openbraces/CPSC-6820/README.md

# CPSC-6820 Classwork

## Resources

- For composing LaTeX documents, VScode with [LaTeX Workshop](https://marketplace.visualstudio.com/items?itemName=James-Yu.latex-workshop) can be used. I personally have a full TeX Live distribution installed on my machine.
