openbraces/CPSC-6820/Deliverable #2/document.tex

\documentclass{article}

\usepackage{graphicx}
\usepackage{booktabs}
\usepackage{array}
\usepackage{lscape}
\usepackage{tikz}
\usetikzlibrary{shapes.geometric, shapes.misc, positioning, arrows}
\usepackage{float}
\usepackage{tabularx}
\usepackage[colorlinks=true,urlcolor=blue,bookmarksopen=true]{hyperref}
\usepackage{ltxtable}

\title{Automatic Pet Feeder\\
\large CPSC-6820 Deliverable \#2---System Overview Document}
\author{Logan Swoyer \and Sriram Vishnubhotla}
\date{February 2025}

\begin{document}

\maketitle

\section{Executive Summary}
It feels terrible to realize we did not feed our pets---whether it is because we were running late and were in a hurry or had too much on our mind and forgot about it. Times like these are when the Automatic Pet Feeder comes in handy. It comes with a nifty set of features to take care of your pet feeding needs including---the ability to set multiple food dispense times a day, on-device dispense schedule settings, internet connectivity to pair your mobile devices and publish logs, a mobile app to receive notifications and view logs as well as to set the dispense schedule and the ability to set dispense quantities per each dispense time. Internet connectivity is completely optional and is helpful to check logs and remotely edit the dispense schedule.

\section{System Description}
\subsection{Software}
The device's main loop can be logically divided into three phases: reading from and writing to I/O---including rendering on-device display based on button inputs and activating the buzzer, pushing device state to the web server and updating the local state from the web server's state, setting the timers based on the schedules and dispensing food when the timers are triggered. The following sections lay out more details of these phases.
\subsubsection{Device I/O}
For the device to be self-sufficient without internet connectivity, the on-device display needs to act as a comprehensive user interface. <figure> shows the planned frame layout. The frame consists of a number input at the center to take schedule times and portion sizes as inputs, icons on the left---including internet connectivity indicator, storage level indicator and schedule identifier. The schedule identifier can be toggled to view or edit multiple schedules, each of which is identified by the identifier. The display would be controlled using a joystick--select button combo input and a buzzer would be fired to alert the pet/user when dispensing food.
\subsubsection{Web Interoperation}
The device would be equipped with a Wi-Fi module that sets up a private wireless network to pair with a mobile device, which needs a client app installed. The user's home network credentials will then be exchanged with the device for it to establish a connection with the network. Once this step succeeds, the device would be ready to go online and synchronize device state with data on the server. This includes the device clock and the dispense schedule and portion sizes. From this point, the device would push activity data to the server---which would be used by the mobile app, for instance, to notify the user when food is dispensed or if the storage level is low.
\subsubsection{Scheduling and Dispensing}
% TODO: Research on MSP430 timer limits and check if a dedicated timer is required.
Schedules are set using the microcontroller's online timers and TI's RTC library. The timer interrupts trigger the device to serve food in the container.
\subsubsection{UI}
The device's user interface would consist of a power on--off switch, a joystick, a buzzer and an LCD display. The joy stick will be used by the user to control selection on the LCD display. The LCD display will visualize setting the device clock, the dispense schedule and portion sizes and alert the user of warnings. The buzzer is used in order to alert the user or pet when food is being dispensed.

Besides this, a companion mobile app will be developed to achieve the same functionality remotely, while accessing device logs.
\begin{figure}[H]
    
    \caption{Device display prototype.}
\end{figure}
\subsection{State Machine}
\begin{figure}[H]
    \centering
    \input{statemachine.tex}
    \caption{Automatic Pet Feeder's state machine.}
\end{figure}
\subsection{Hardware}
\subsubsection{Sensors}
The device will have two sensors, a force sensor and an optical sensor. The force sensor is used to measure the amount of food in the dispense container before and during dispensing. This will allow the device to dispense the proper amount of food set by the user. The optical sensor is used in order to measure the amount of food left in the storage. This allows the user to be alerted when food is running low so they can refill it.
\subsubsection{Microcontroller}
We plan to use MSP430FR5994 in order to control this device. Using this microcontroller eases the workload since we can reuse the knowledge of the MCU we learned in class.
\subsubsection{Actuator}
The device will be equipped with a linear actuator that will be in charge of opening and closing the dispenser. We made sure to choose one that can handle enough force to reliably hold the weight of the food.
\subsubsection{Wireless communication protocol}
For our wireless component we decided to use a Wi-Fi module. This module will be used to connect to the user's home network and communicate with the web server.
\subsection{Parts}
\begin{table}[H]
    \begin{tabularx}{\linewidth}{@{} X X >{\raggedleft\hsize=0.25\hsize}X X @{}}
        \toprule
        Title                                                                                                                          & Part \#                   & Price & Supplier              \\ \midrule
        \href{https://www.sparkfun.com/rocker-switch-spst-round.html}{Rocker Switch}                                                   & COM-11138                 & 0.55  & Sparkfun              \\ \midrule
        \href{https://www.adafruit.com/product/512}{Joystick with Select Button}                                                       & 512                       & 5.95  & Adafruit              \\ \midrule
        \href{https://www.digikey.com/en/products/detail/tdk-corporation/PS1240P02BT/935924}{Buzzer}                                   & PS1240P02BT               & 0.55  & TDK Corporation       \\ \midrule
        \href{https://www.digikey.com/en/products/detail/newhaven-display-intl/NHD-C12832A1Z-NSW-BBW-3V3/2059235}{Graphic LCD Display} & NHD-C12832A1Z-NSW-BBW-3V3 & 12.82 & Newhaven Display Intl \\ \midrule
        \href{https://www.digikey.com/en/products/detail/espressif-systems/ESP32-S2FH4/14553010}{WiFi Module}                          & ESP32-S2FH4               & 1.48  & Espressif Systems     \\ \midrule
        \href{https://www.digikey.com/en/products/detail/dfrobot/FIT0803/14824998}{Linear actuator}                                    & FIT0803                   & 24.00 & DFRobot               \\ \midrule
        \href{https://www.digikey.com/en/products/detail/texas-instruments/MSP-EXP430FR5994/6645208}{MSP430FR5994 Microcontroller}     & MSP-EXP430FR5994          & 20.39 & Texas Instruments     \\ \midrule
        \href{https://www.digikey.com/en/products/detail/uneo-inc/GHF-10/15657152}{Force sensor}                                       & GHF-10                    & 5.86  & UNEO Inc.             \\ \midrule
        \href{https://www.digikey.com/en/products/detail/stmicroelectronics/VL6180V1NR-1/7313209}{Optical sensor}                      & VL6180V1NR/1              & 3.37  & STMicroelectronics    \\ \midrule
                                                                                                                                       &                           & 74.97 &                       \\ \bottomrule
    \end{tabularx}
    \caption{Device part list and details.}
\end{table}
\section{Demo}
The demo would begin with us showing the audience the design and features of the device. We would then fill the storage with food, set the dispense container up to collect the food and power the device on. Once done, we would demonstrate the setup phase---which will involve pairing the device with user's mobile and connecting it to a wireless network, followed by setting the feeding schedule and portion sizes. For demonstration purposes, we would set short time intervals to show the functionality. Finally, once everything is set up, we show the device alerting and dispensing the food on time, as well as pushing notifications to the user's mobile device.
\section{Resources, References and Appendix}
\begin{itemize}
    \item \href{https://www.ti.com/lit/an/slaa290a/slaa290a.pdf}{TI---Using the Real-Time Clock Library}
    \item \href{https://software-dl.ti.com/trainingTTO/trainingTTO_public_sw/MSP430_LaunchPad_Workshop/v4/Chapters/MSP430m06_TIMERS.pdf}{TI---Timers}
    \item \href{https://www.ti.com/video/series/msp430-workshop.html}{TI---MSP430 workshop}
    \item \href{https://e2e.ti.com/support/microcontrollers/msp-low-power-microcontrollers-group/msp430/f/msp-low-power-microcontroller-forum/670685/ccs-msp430fr5994-how-to-set-up-t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}{TI forums---Setting up alarms using RTC library}
   \item \href{https://www.espressif.com/sites/default/files/documentation/esp32-s2_datasheet_en.pdf}{WiFi Module Datasheet}
\end{itemize}
\end{document}
