openbraces/CPSC-6820/Deliverable #2/presentation.pdf

## Automatic Pet Feeder

CPSC-6820 Deliverable #2
System Overview Presentation

Sriram Vishnubhotla Logan Swoyer

Clemson University

February 2025

## What and why?

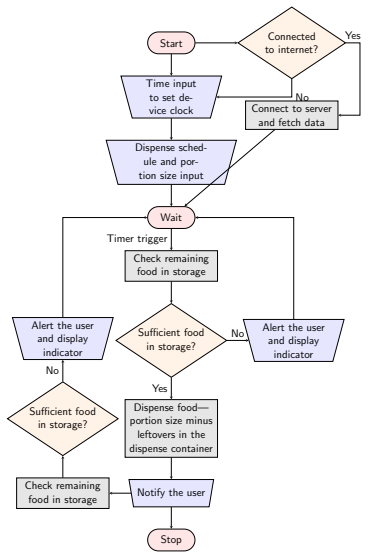
[picture p5: figure]
Start; Time input to set de- vice clock; Dispense sched- ule and por- tion size input; Connected to internet?; Connect to server and fetch data; Wait; Check remaining food in storage; Sufficient food in storage?; Alert the user and display indicator; Dispense food— portion size minus leftovers in the dispense container; Notify the user Check remaining food in storage; Stop; Yes; Timer trigger

What?
- Automatic Pet Feeder
- Set-and-forget food
dispenser for pets

Features:
- Multiple schedules and
portion sizes per schedule
- Wireless connectivity, user alerts and stats
- Replaceable dispense
containers
Why?
- Don’t miss feeding your pets again!
- Privacy and wallet friendly

## Software and UI

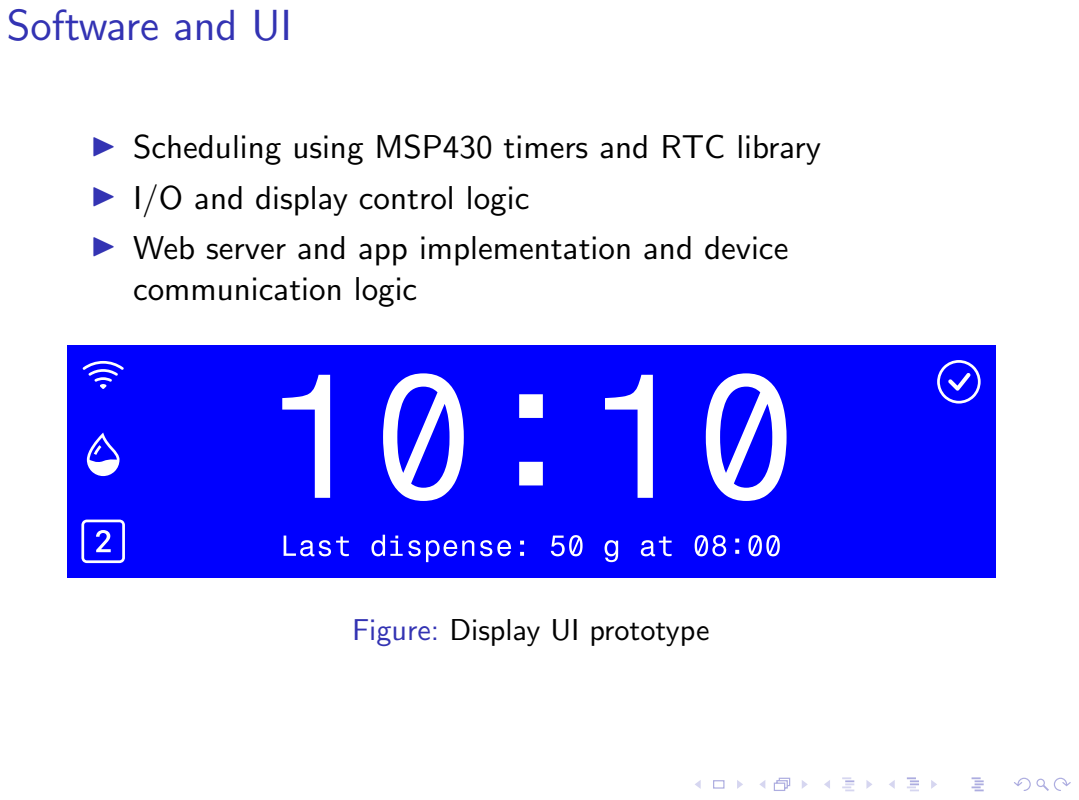
[picture p6: page 3]

▶ Scheduling using MSP430 timers and RTC library
▶ I/O and display control logic
▶ Web server and app implementation and device
communication logic

Last dispense: 50 g at 08:00

Figure: Display UI prototype

## Hardware

Part | Price
Rocker Switch | 0.55
Joystick with Select Button | 5.95
Buzzer | 0.55
Graphic LCD Display | 12.82
WiFi Module | 1.48
Linear actuator | 24.00
MSP430FR5994 Microcontroller | 20.39
Force sensor | 5.86
Optical sensor | 3.37
| 74.97

## Stretch Goals

- Storage partitioning and different types of food
- Battery-powered operation
- Keeping track of pet’s eating habits
- Pet-lock function

## Conclusion

Questions?
