openbraces/CPSC-6820/Deliverable #2/images/displayframe.pdf

10:10

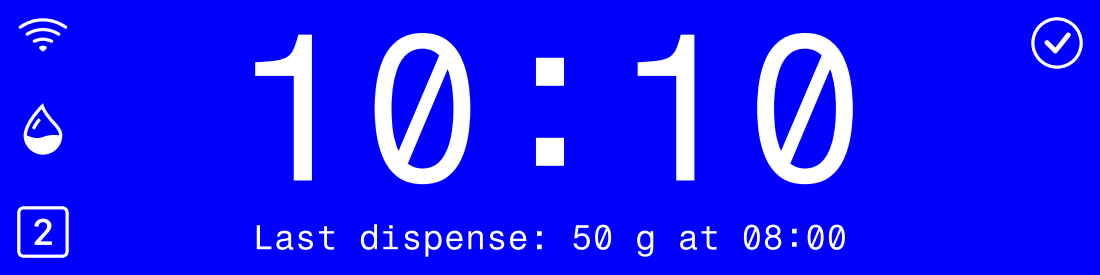
[picture p7: page 1]

Last dispense: 50 g at 08:00
