openbraces/CPSC-6820/Deliverable #6a/dinmeter.jpg

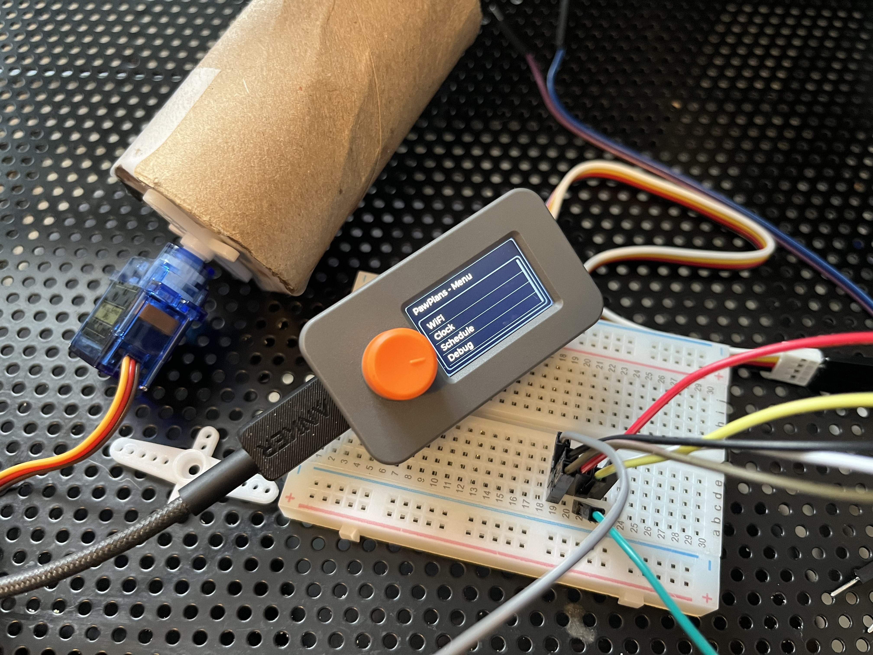
Deliverable #6a/dinmeter.jpg
