openbraces/CPSC-6820/Deliverable #3/Parts/Load Cell Amp (SEN-13879)/SEN-13879.step

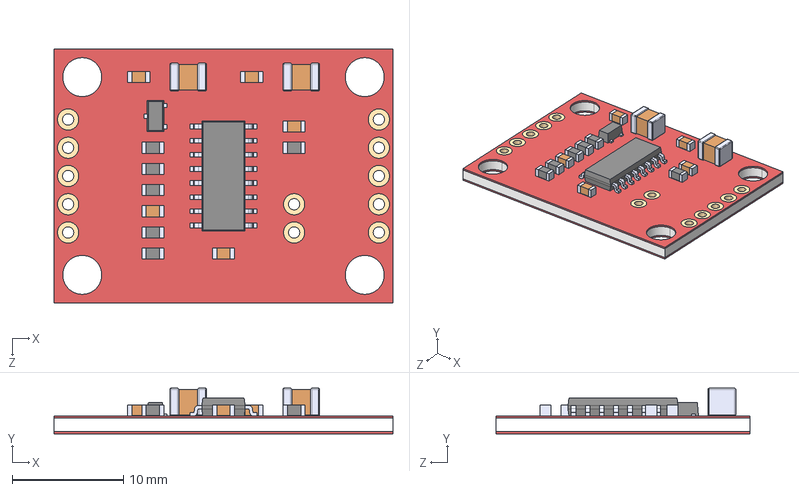
[picture p9: CAD file, 2025-02-20]
Deliverable #3/Parts/Load Cell Amp (SEN-13879)/SEN-13879.step
30.5 x 4.10 x 22.9 mm
