openbraces/CPSC-6820/PawPlans/Hardware/petfeeder2.stl

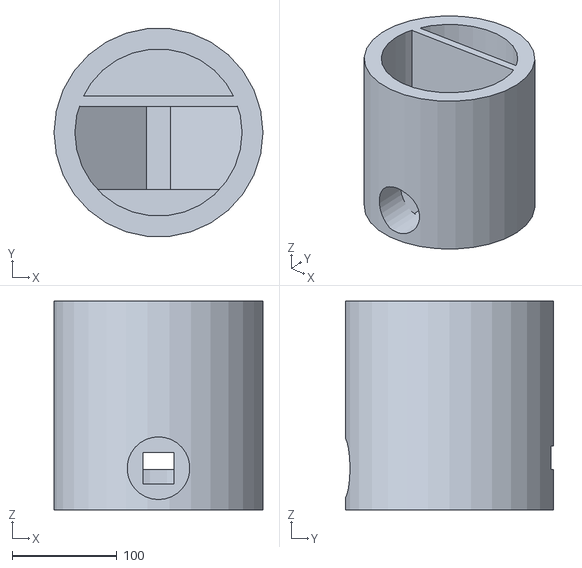
[picture p10: CAD file, 2025-04-15]
PawPlans/Hardware/petfeeder2.stl
200.0 x 198.9 x 200.0
