openbraces/CPSC-6820/PawPlans/Hardware/PawPlans.kicad_pcb

## KiCad design PawPlans/Hardware/PawPlans.kicad_pcb (2025-04-25)

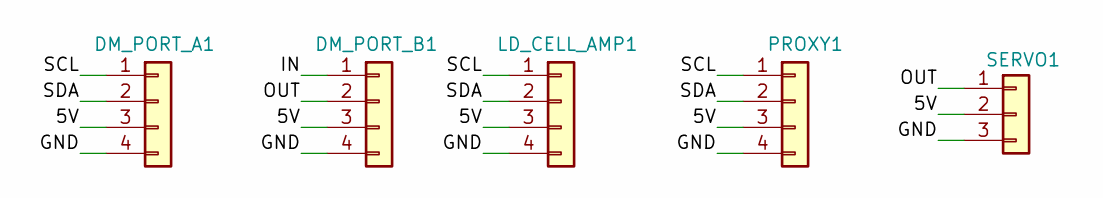
[picture p11: schematic PawPlans.kicad_sch, PawPlans - Automatic Pet Feeder]

Parts:
DM_PORT_A1: Conn_01x04; PinHeader_1x04_P2.54mm_Vertical
DM_PORT_B1: Conn_01x04; PinHeader_1x04_P2.54mm_Vertical
LD_CELL_AMP1: Conn_01x04; PinHeader_1x04_P2.54mm_Vertical
PROXY1: Conn_01x04; PinHeader_1x04_P2.54mm_Vertical
SERVO1: Conn_01x03; PinHeader_1x03_P2.54mm_Vertical

Connections:
/5V: DM_PORT_A1.3 (5V), DM_PORT_B1.3 (5V), LD_CELL_AMP1.3 (5V), PROXY1.3 (5V), SERVO1.2 (5V)
/GND: DM_PORT_A1.4 (GND), DM_PORT_B1.4 (GND), LD_CELL_AMP1.4 (GND), PROXY1.4 (GND), SERVO1.3 (GND)
/IN: DM_PORT_B1.1 (IN)
/OUT: DM_PORT_B1.2 (OUT), SERVO1.1 (SGN)
/SCL: DM_PORT_A1.1 (SCL), LD_CELL_AMP1.1 (SCL), PROXY1.1 (SDA)
/SDA: DM_PORT_A1.2 (SDA), LD_CELL_AMP1.2 (SDA), PROXY1.2 (SDA)

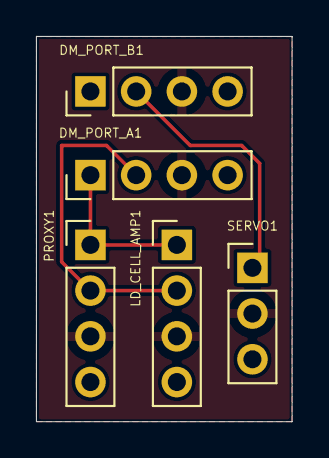
[picture p12: board PawPlans.kicad_pcb from above]

Board: 2 copper layers, 14.2 x 21.4 mm, 5 parts (0 on the bottom side), 5 nets.
