openbraces/CPSC-6820/Deliverable #3/Automatic Pet Feeder.sch

## EAGLE design Deliverable #3/Automatic Pet Feeder.sch (2025-02-20)

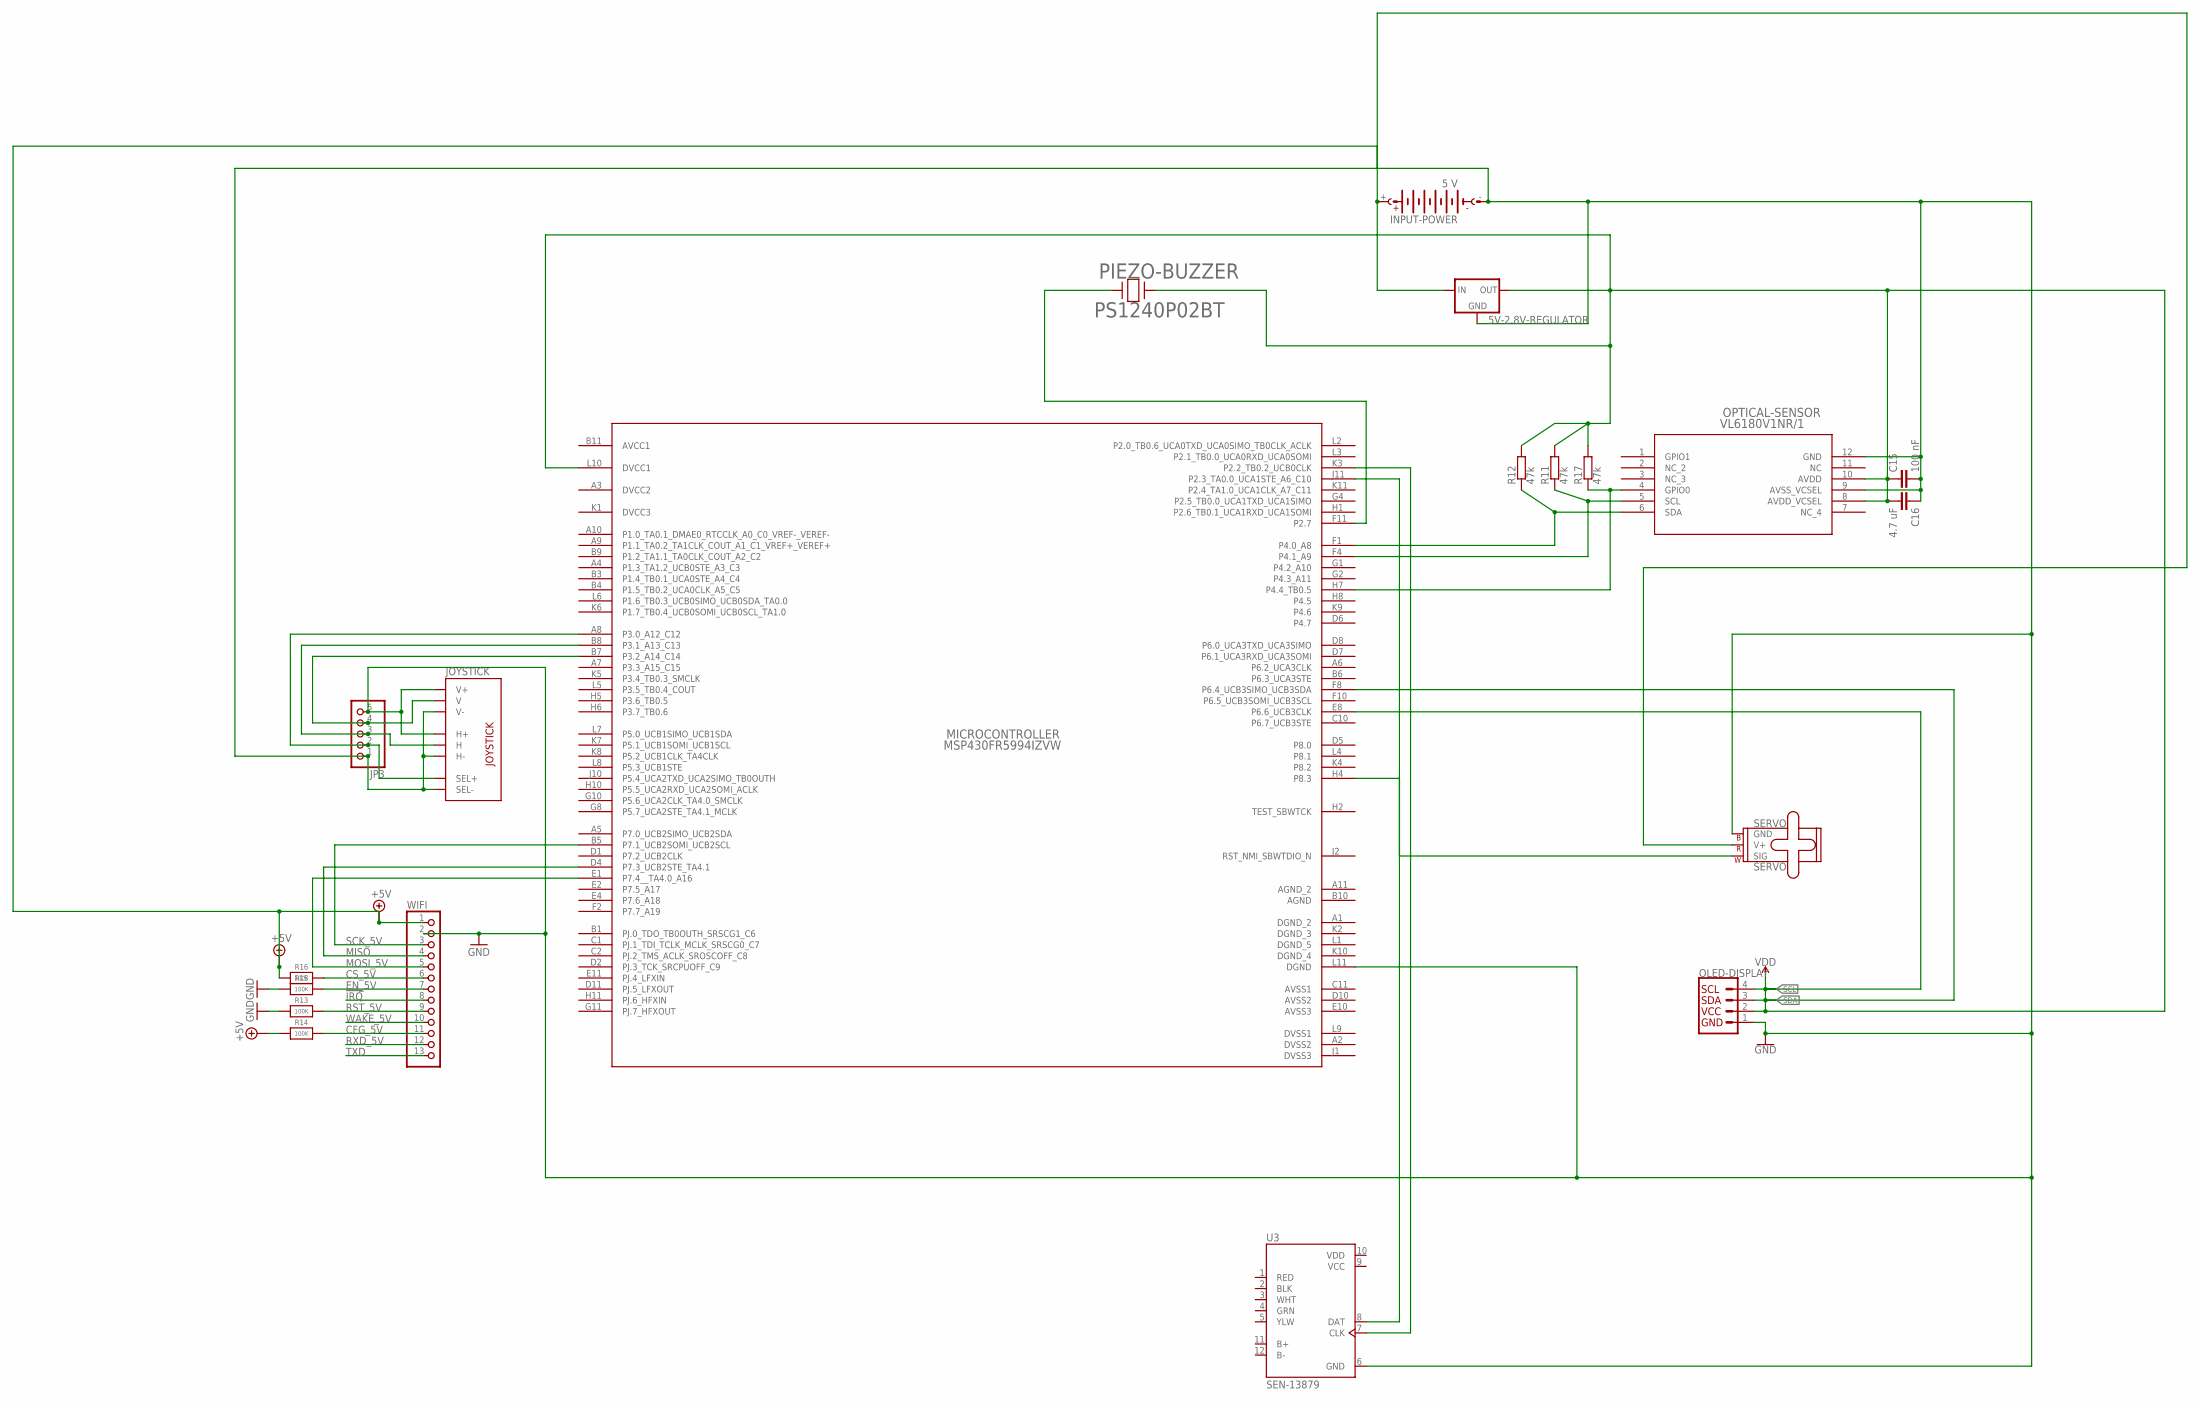
[picture p16: schematic Automatic Pet Feeder.sch, sheet 1]

Parts:
5V-2.8V-REGULATOR: 78XXS
C15: 100 nF; C2.5-2
C16: 4.7 uF; C2.5-2
INPUT-POWER: 5 V; AB9V
JOYSTICK: JOYSTICKPTH; JOYSTICK
JP3: PINHD-1X5; 1X05
MICROCONTROLLER: MSP430FR5994IZVW; ZVW0087A
OLED-DISPLAY: I2C_STANDARD_NO_SILK; 1X04_NO_SILK
OPTICAL-SENSOR: VL6180V1NR/1; VL6180X_STM
PIEZO-BUZZER: PS1240P02BT; XTAL_PS1240P02BT_TDK
R11, R12, R17: 47k; PMD
R13, R14: 100K; 0805-NO
R15, R16: 100K; _0805MP
SERVO: SERVO; 1X03
U3: SEN-13879; SPARKFUN_SEN-13879
WIFI: HEADER-1X13; 1X13_ROUND_70

Connections:
!IRQ: WIFI.8
+5V: 5V-2.8V-REGULATOR.IN, INPUT-POWER.+, R14.1, R16.1, WIFI.1
CFG_5V: R14.2, WIFI.11
CS_5V: R16.2, WIFI.6
EN_5V: R15.2, WIFI.7
GND: 5V-2.8V-REGULATOR.GND, C15.2, C16.1, INPUT-POWER.-, JOYSTICK.B2A (SEL-), JOYSTICK.H1 (H+), JOYSTICK.H3 (H-), JOYSTICK.V1 (V+), JOYSTICK.V3 (V-), JP3.1, JP3.5, MICROCONTROLLER.L11 (DGND), OLED-DISPLAY.1 (GND), OPTICAL-SENSOR.9 (AVSS_VCSEL), OPTICAL-SENSOR.12 (GND), R13.1, R15.1, SERVO.3 (GND), U3.6 (GND), WIFI.2
MISO: MICROCONTROLLER.D4 (P7.3_UCB2STE_TA4.1), WIFI.4
MOSI_5V: MICROCONTROLLER.E1 (P7.4__TA4.0_A16), WIFI.5
unnamed: MICROCONTROLLER.H4 (P8.3), SERVO.1 (SIG)
unnamed: MICROCONTROLLER.K3 (P2.2_TB0.2_UCB0CLK), U3.7 (CLK)
unnamed: JOYSTICK.V2 (V), JP3.4, MICROCONTROLLER.B7 (P3.2_A14_C14)
unnamed: JOYSTICK.H2 (H), JP3.3, MICROCONTROLLER.B8 (P3.1_A13_C13)
unnamed: JOYSTICK.B1A (SEL+), JP3.2, MICROCONTROLLER.A8 (P3.0_A12_C12)
unnamed: MICROCONTROLLER.F11 (P2.7), PIEZO-BUZZER.1
unnamed: MICROCONTROLLER.J11 (P2.3_TA0.0_UCA1STE_A6_C10), U3.8 (DAT)
unnamed: MICROCONTROLLER.H7 (P4.4_TB0.5), OPTICAL-SENSOR.4 (GPIO0), R17.2
unnamed: MICROCONTROLLER.F4 (P4.1_A9), OPTICAL-SENSOR.5 (SCL), R11.2
unnamed: MICROCONTROLLER.F1 (P4.0_A8), OPTICAL-SENSOR.6 (SDA), R12.2
RST_5V: R13.2, WIFI.9
RXD_5V: WIFI.12
SCK_5V: MICROCONTROLLER.B5 (P7.1_UCB2SOMI_UCB2SCL), WIFI.3
SCL: OLED-DISPLAY.4 (SCL)
SDA: OLED-DISPLAY.3 (SDA)
TXD: WIFI.13
VDD: 5V-2.8V-REGULATOR.OUT, C15.1, C16.2, MICROCONTROLLER.E8 (P6.6_UCB3CLK), MICROCONTROLLER.F8 (P6.4_UCB3SIMO_UCB3SDA), MICROCONTROLLER.L10 (DVCC1), OLED-DISPLAY.2 (VCC), OPTICAL-SENSOR.8 (AVDD_VCSEL), OPTICAL-SENSOR.10 (AVDD), PIEZO-BUZZER.2, R11.1, R12.1, R17.1
WAKE_5V: WIFI.10
