openbraces/CPSC-6820/Deliverable #3/Automatic_Pet_Feeder_1.kicad_sch

## KiCad design Deliverable #3/Automatic_Pet_Feeder_1.kicad_sch (2025-02-27)

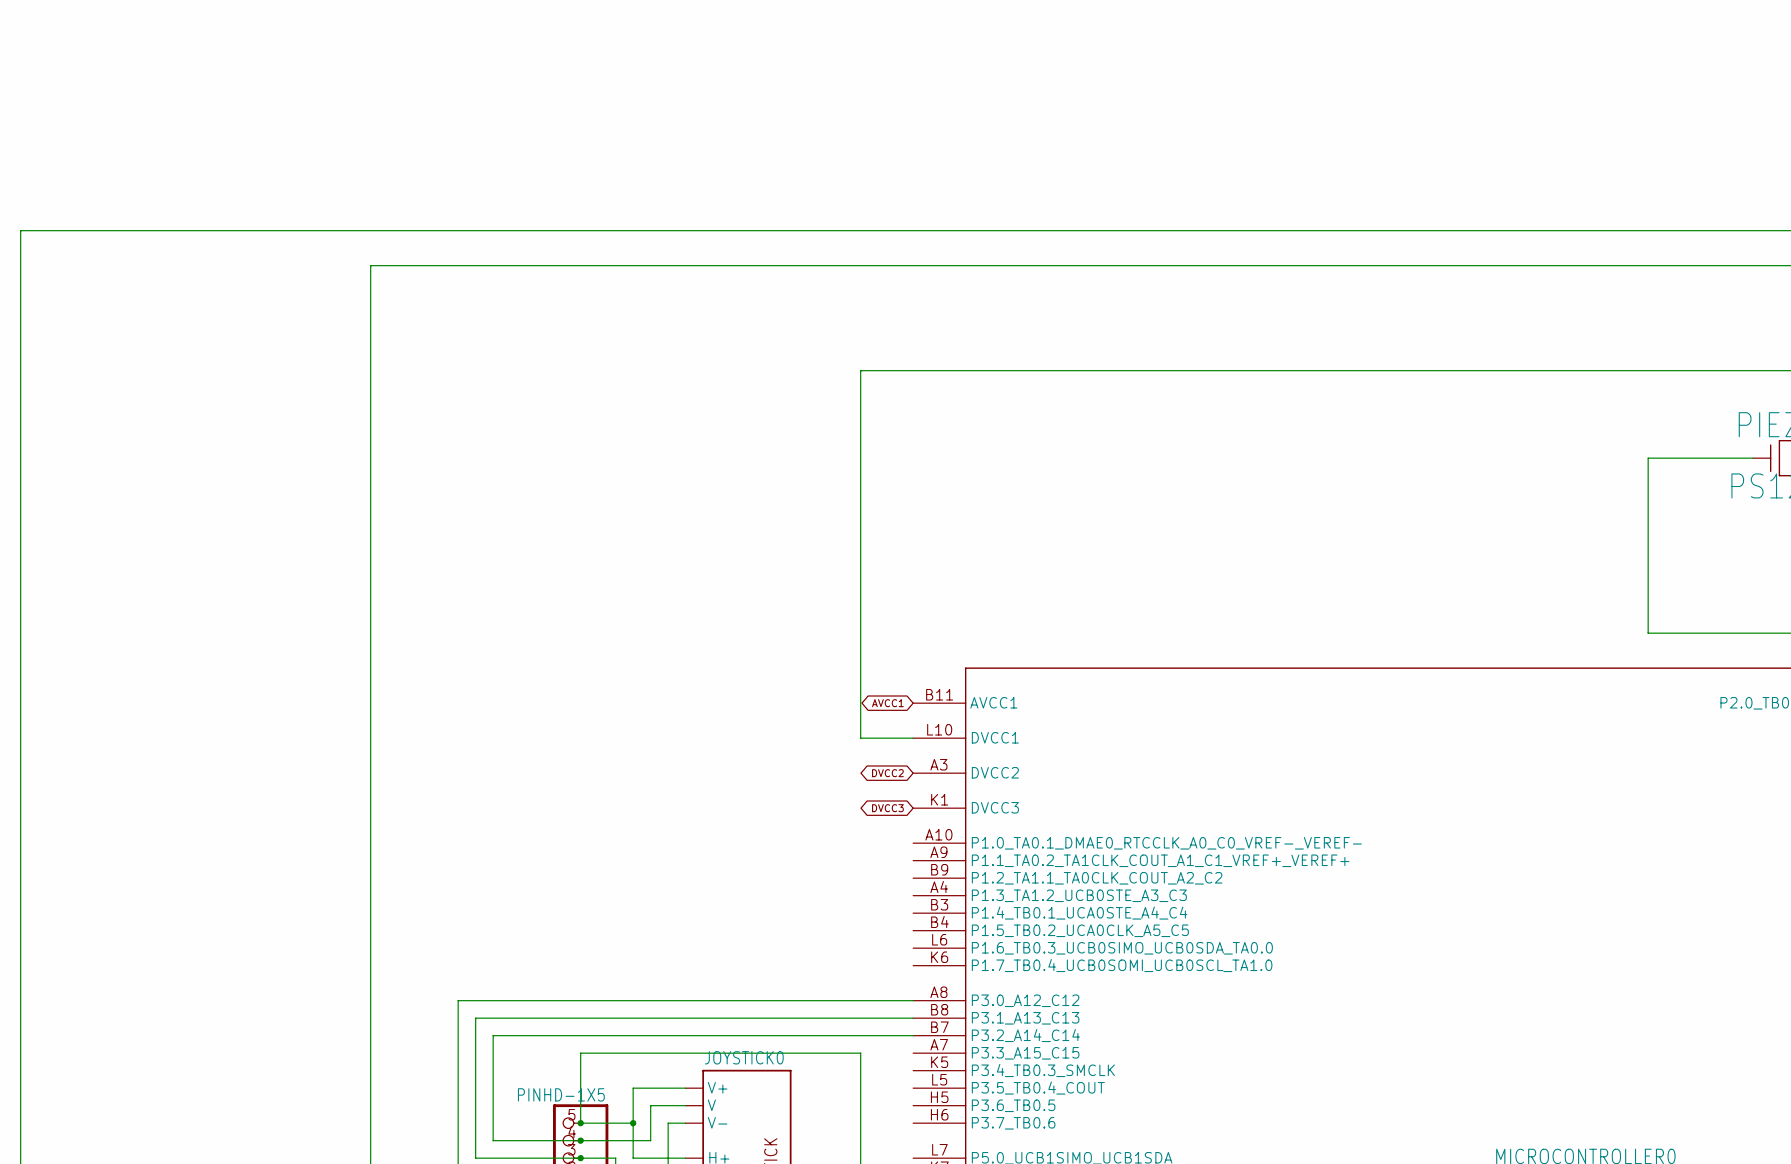
[picture p17: schematic Automatic_Pet_Feeder_1.kicad_sch, part in row 1, column 1]

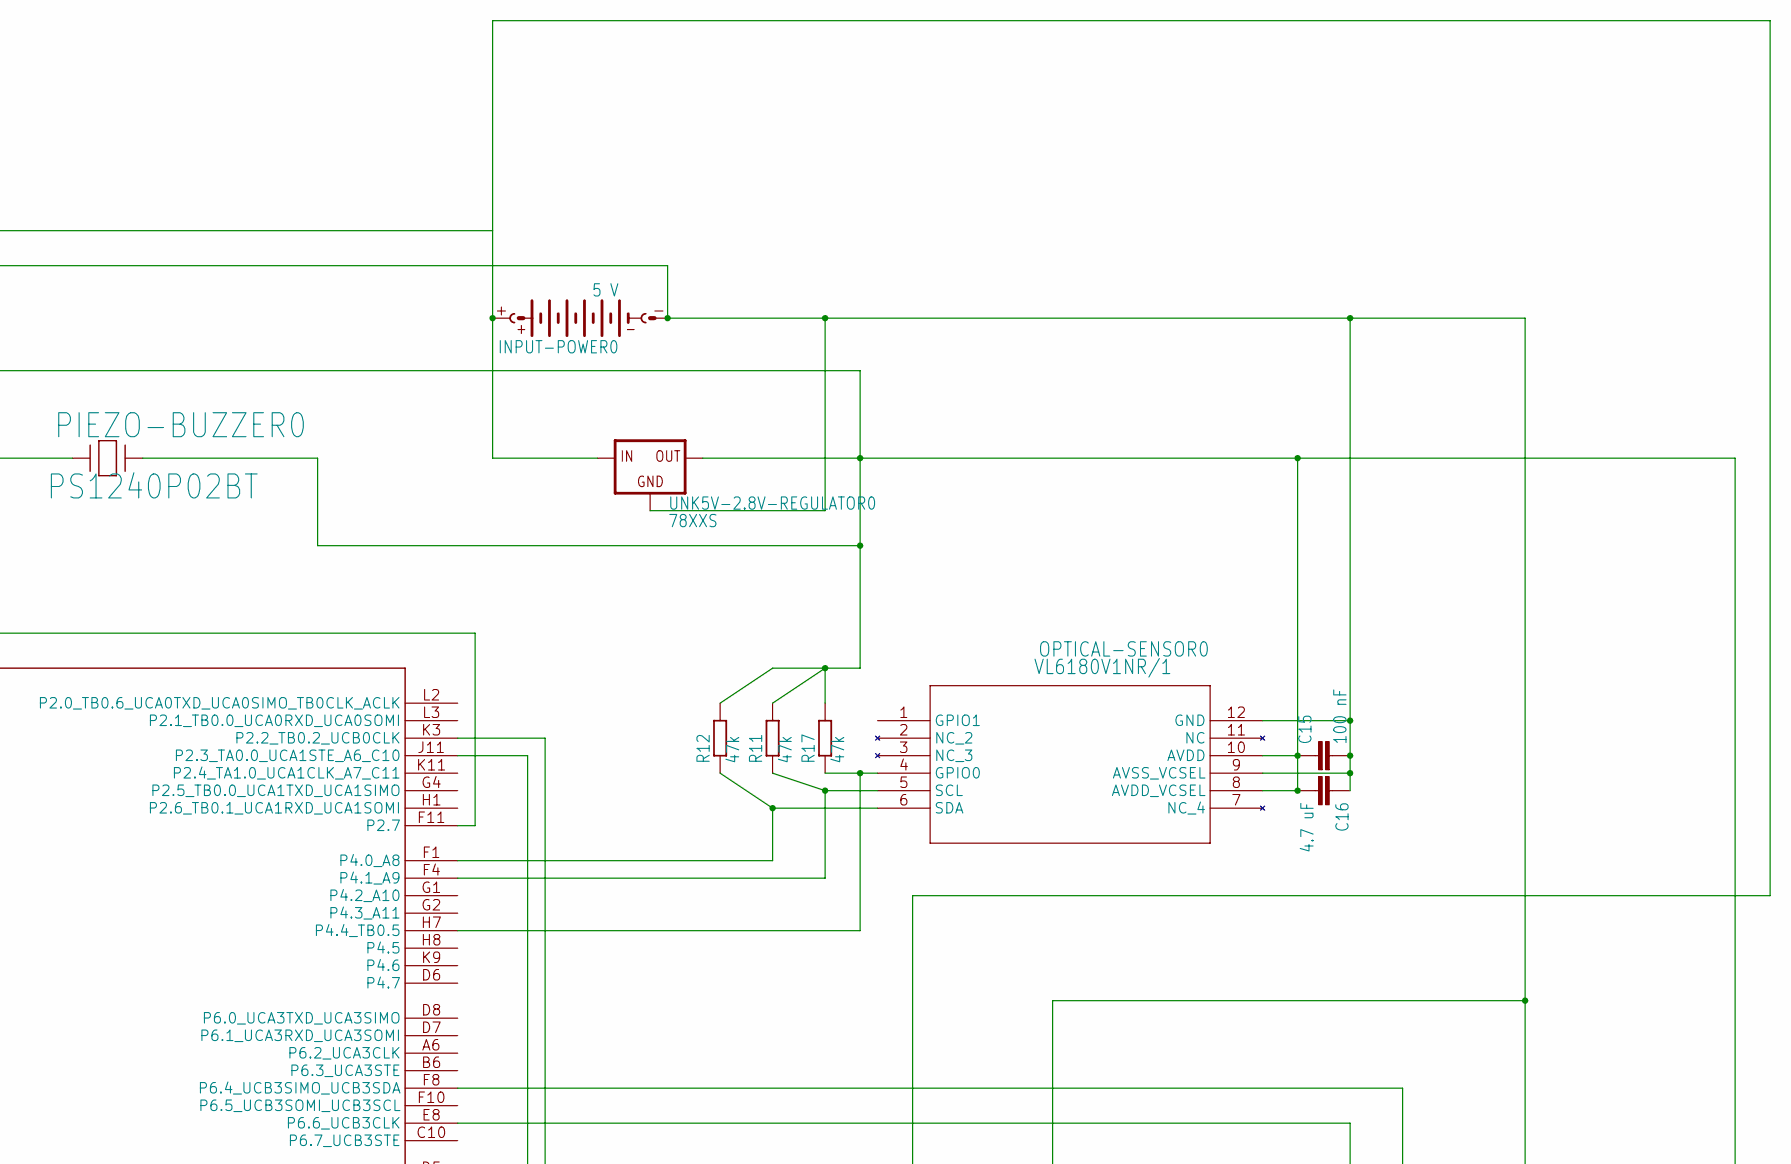
[picture p18: schematic Automatic_Pet_Feeder_1.kicad_sch, part in row 1, column 2]

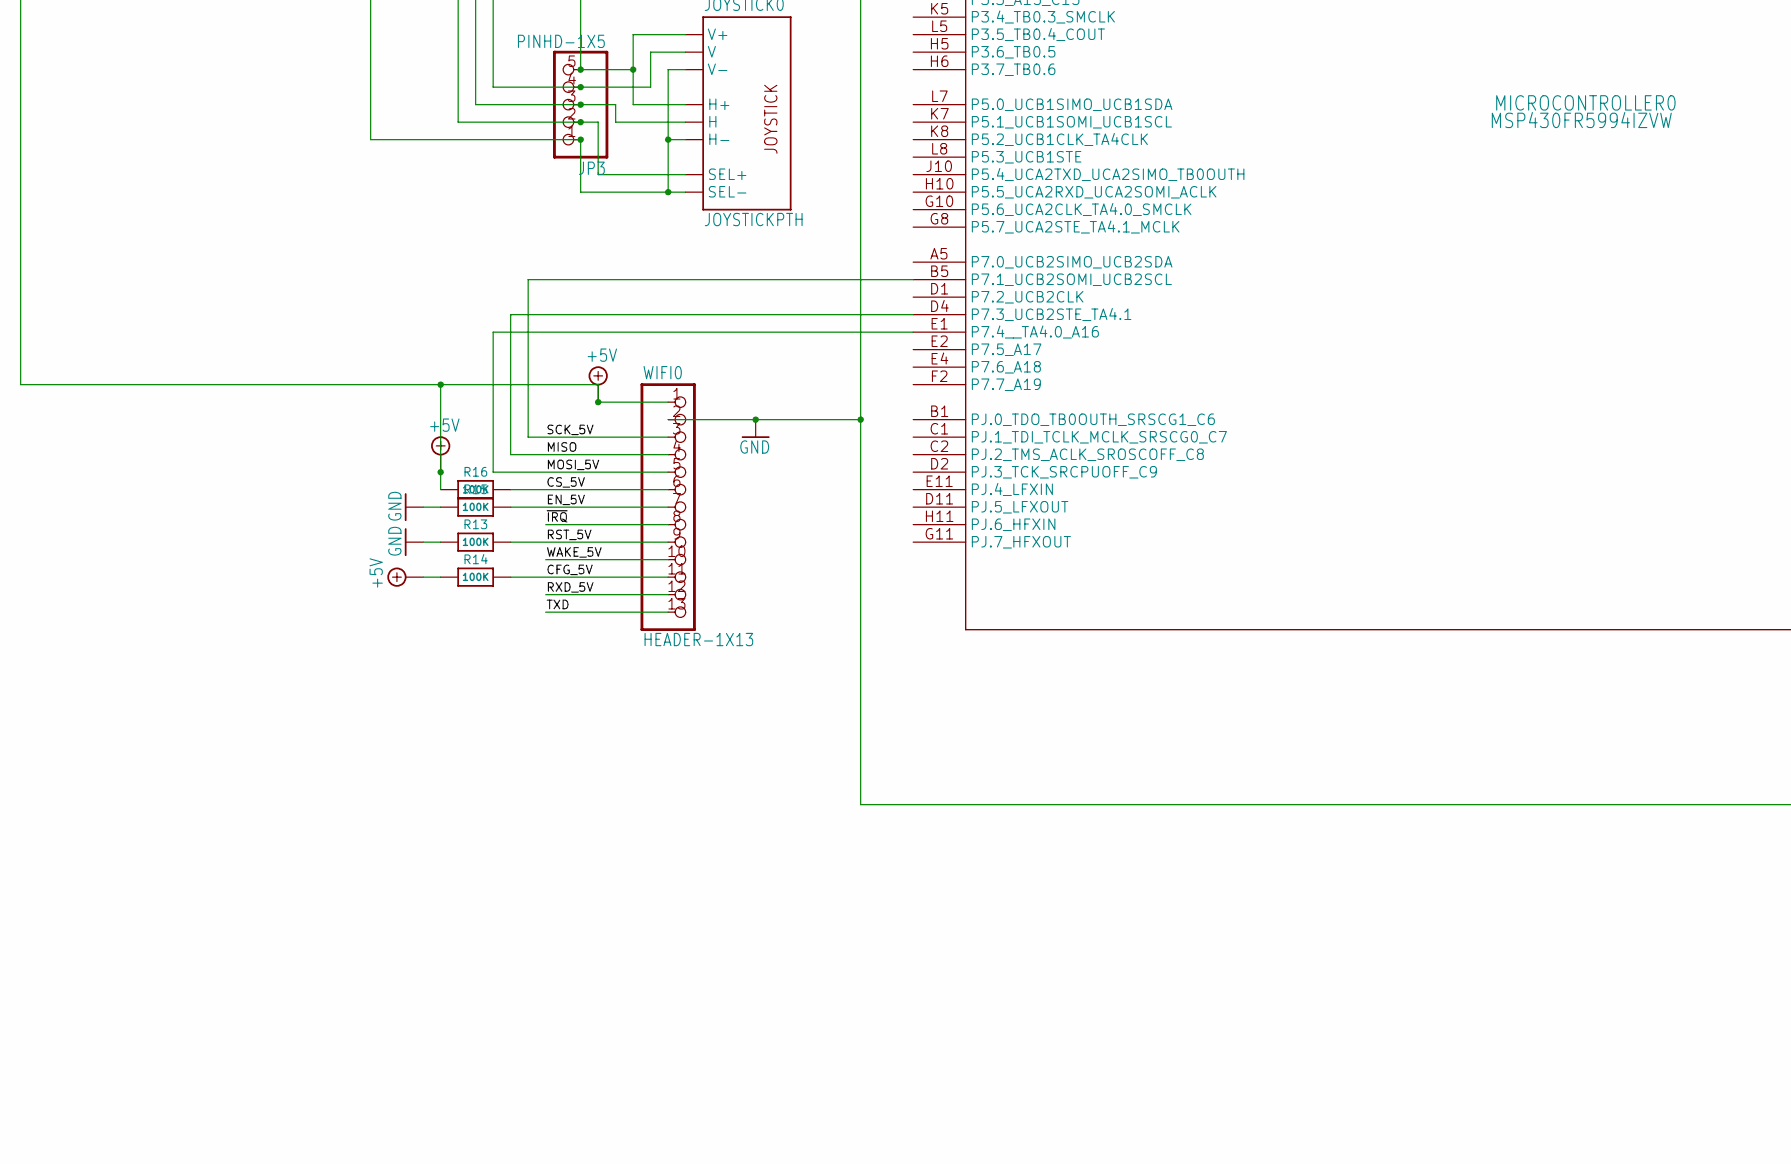
[picture p19: schematic Automatic_Pet_Feeder_1.kicad_sch, part in row 2, column 1]

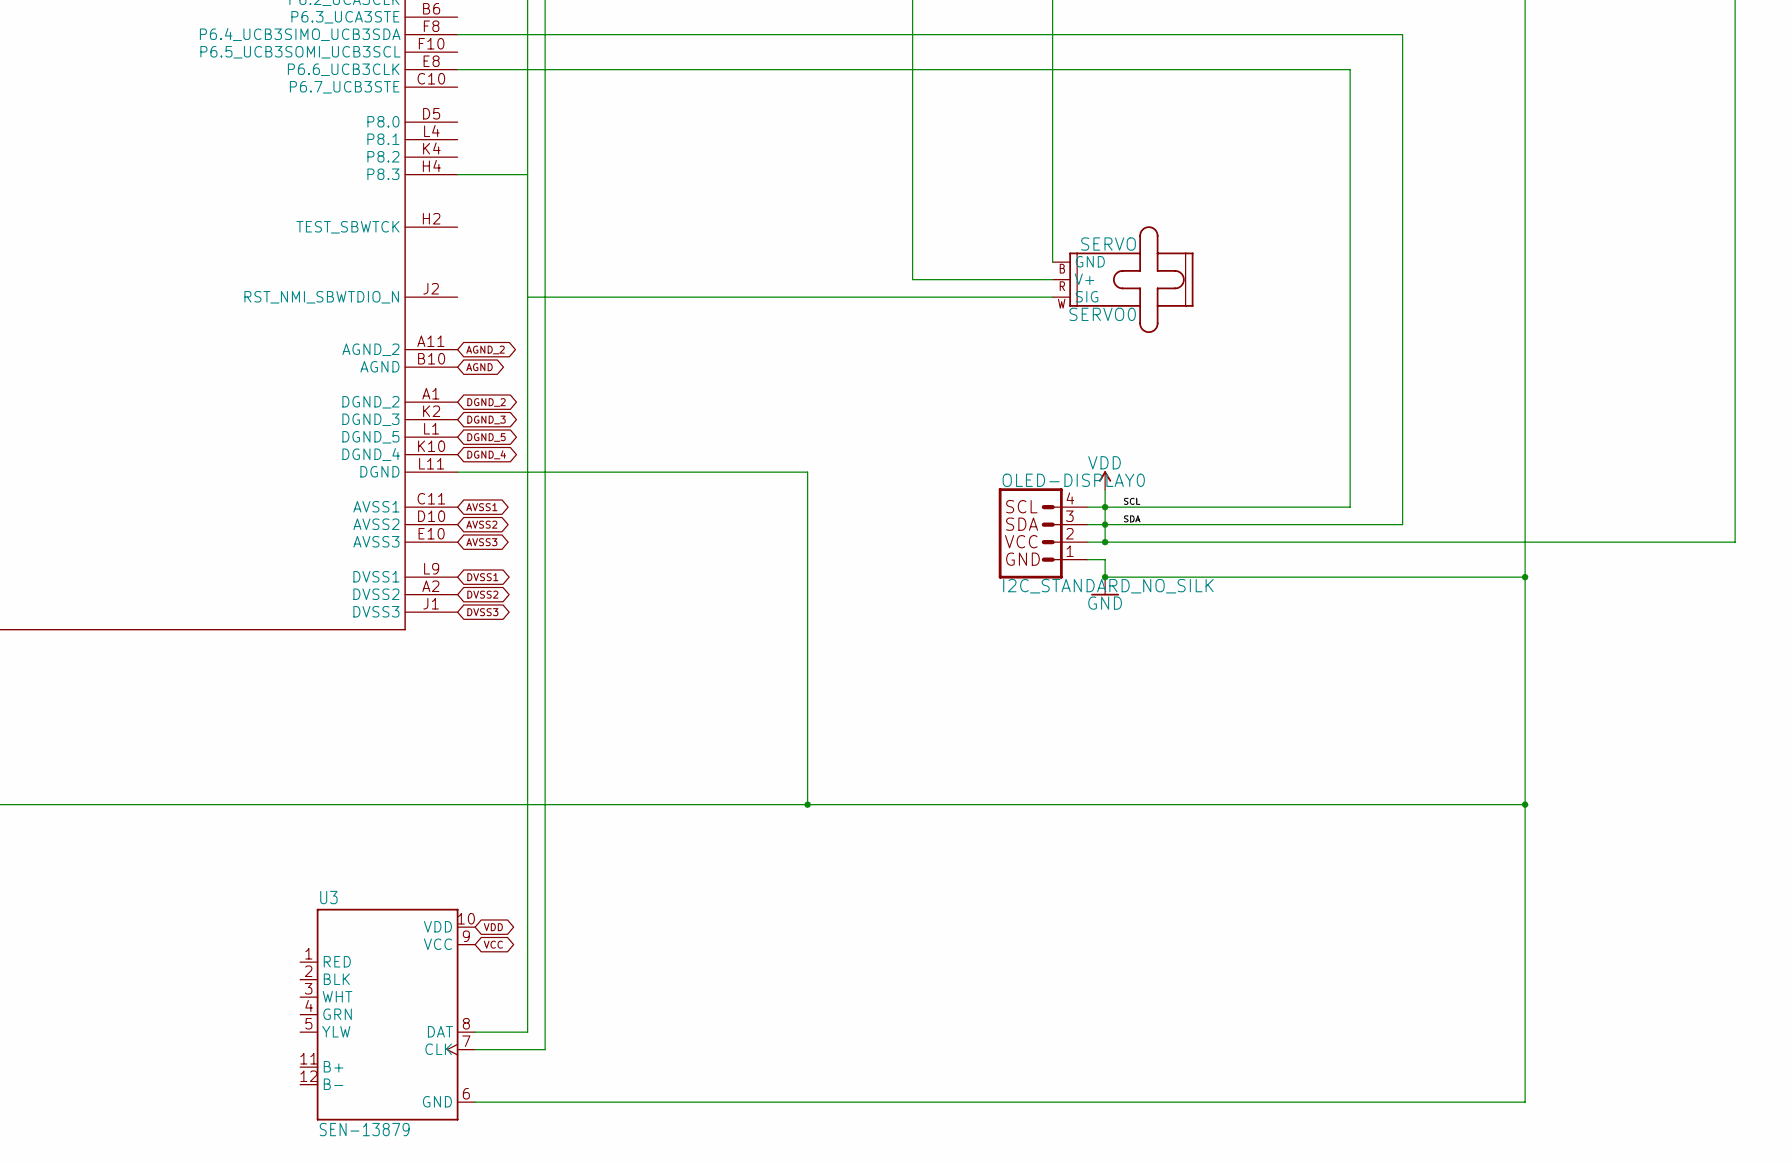
[picture p20: schematic Automatic_Pet_Feeder_1.kicad_sch, part in row 2, column 2]

Parts:
C15: 100 nF; C2.5-2
C16: 4.7 uF; C2.5-2
INPUT-POWER0: 5 V; AB9V
JOYSTICK0: JOYSTICKPTH; JOYSTICK
JP3: PINHD-1X5; 1X05
MICROCONTROLLER0: MSP430FR5994IZVW; ZVW0087A
OLED-DISPLAY0: I2C_STANDARD_NO_SILK; 1X04_NO_SILK
OPTICAL-SENSOR0: VL6180V1NR/1; VL6180X_STM
PIEZO-BUZZER0: PS1240P02BT; XTAL_PS1240P02BT_TDK
R11, R12, R17: 47k; PMD
R13, R14: 100K; 0805-NO
R15, R16: 100K; _0805MP
SERVO0: SERVO; 1X03
U3: SEN-13879; SPARKFUN_SEN-13879
UNK5V-2.8V-REGULATOR0: 78XXS
WIFI0: HEADER-1X13; 1X13_ROUND_70

Connections:
+5V: R14.1, R16.1, WIFI0.1
AGND: MICROCONTROLLER0.B10 (AGND)
AGND_2: MICROCONTROLLER0.A11 (AGND_2)
AVCC1: MICROCONTROLLER0.B11 (AVCC1)
AVSS1: MICROCONTROLLER0.C11 (AVSS1)
AVSS2: MICROCONTROLLER0.D10 (AVSS2)
AVSS3: MICROCONTROLLER0.E10 (AVSS3)
CFG_5V: R14.2, WIFI0.11
CS_5V: R16.2, WIFI0.6
DGND_2: MICROCONTROLLER0.A1 (DGND_2)
DGND_3: MICROCONTROLLER0.K2 (DGND_3)
DGND_4: MICROCONTROLLER0.K10 (DGND_4)
DGND_5: MICROCONTROLLER0.L1 (DGND_5)
DVCC2: MICROCONTROLLER0.A3 (DVCC2)
DVCC3: MICROCONTROLLER0.K1 (DVCC3)
DVSS1: MICROCONTROLLER0.L9 (DVSS1)
DVSS2: MICROCONTROLLER0.A2 (DVSS2)
DVSS3: MICROCONTROLLER0.J1 (DVSS3)
EN_5V: R15.2, WIFI0.7
GND: C15.2, C16.1, INPUT-POWER0.-, JOYSTICK0.B2A (SEL-), JOYSTICK0.H1 (H+), JOYSTICK0.H3 (H-), JOYSTICK0.V1 (V+), JOYSTICK0.V3 (V-), JP3.1, JP3.5, MICROCONTROLLER0.L11 (DGND), OLED-DISPLAY0.1 (GND), OPTICAL-SENSOR0.9 (AVSS_VCSEL), OPTICAL-SENSOR0.12 (GND), R13.1, R15.1, SERVO0.3 (GND), U3.6 (GND), UNK5V-2.8V-REGULATOR0.GND, WIFI0.2
MISO: MICROCONTROLLER0.D4 (P7.3_UCB2STE_TA4.1), WIFI0.4
MOSI_5V: MICROCONTROLLER0.E1 (P7.4__TA4.0_A16), WIFI0.5
unnamed: INPUT-POWER0.+, SERVO0.2 (V+), UNK5V-2.8V-REGULATOR0.IN
unnamed: JOYSTICK0.B1A (SEL+), JP3.2, MICROCONTROLLER0.A8 (P3.0_A12_C12)
unnamed: JOYSTICK0.H2 (H), JP3.3, MICROCONTROLLER0.B8 (P3.1_A13_C13)
unnamed: JOYSTICK0.V2 (V), JP3.4, MICROCONTROLLER0.B7 (P3.2_A14_C14)
unnamed: MICROCONTROLLER0.F1 (P4.0_A8), OPTICAL-SENSOR0.6 (SDA), R12.2
unnamed: MICROCONTROLLER0.F4 (P4.1_A9), OPTICAL-SENSOR0.5 (SCL), R11.2
unnamed: MICROCONTROLLER0.F11 (P2.7), PIEZO-BUZZER0.1
unnamed: MICROCONTROLLER0.H7 (P4.4_TB0.5), OPTICAL-SENSOR0.4 (GPIO0), R17.2
unnamed: MICROCONTROLLER0.J11 (P2.3_TA0.0_UCA1STE_A6_C10), U3.8 (DAT)
unnamed: MICROCONTROLLER0.K3 (P2.2_TB0.2_UCB0CLK), U3.7 (CLK)
RST_5V: R13.2, WIFI0.9
RXD_5V: WIFI0.12
SCK_5V: MICROCONTROLLER0.B5 (P7.1_UCB2SOMI_UCB2SCL), WIFI0.3
TXD: WIFI0.13
VCC: U3.9 (VCC)
VDD: C15.1, C16.2, MICROCONTROLLER0.E8 (P6.6_UCB3CLK), MICROCONTROLLER0.F8 (P6.4_UCB3SIMO_UCB3SDA), MICROCONTROLLER0.L10 (DVCC1), OLED-DISPLAY0.2 (VCC), OLED-DISPLAY0.3 (SDA), OLED-DISPLAY0.4 (SCL), OPTICAL-SENSOR0.8 (AVDD_VCSEL), OPTICAL-SENSOR0.10 (AVDD), PIEZO-BUZZER0.2, R11.1, R12.1, R17.1, U3.10 (VDD), UNK5V-2.8V-REGULATOR0.OUT
WAKE_5V: WIFI0.10
~IRQ: WIFI0.8
