openbraces/CPSC-6820/Deliverable #4/Automatic Pet Feeder.kicad_sch

## KiCad design Deliverable #4/Automatic Pet Feeder.kicad_sch (2025-02-27)

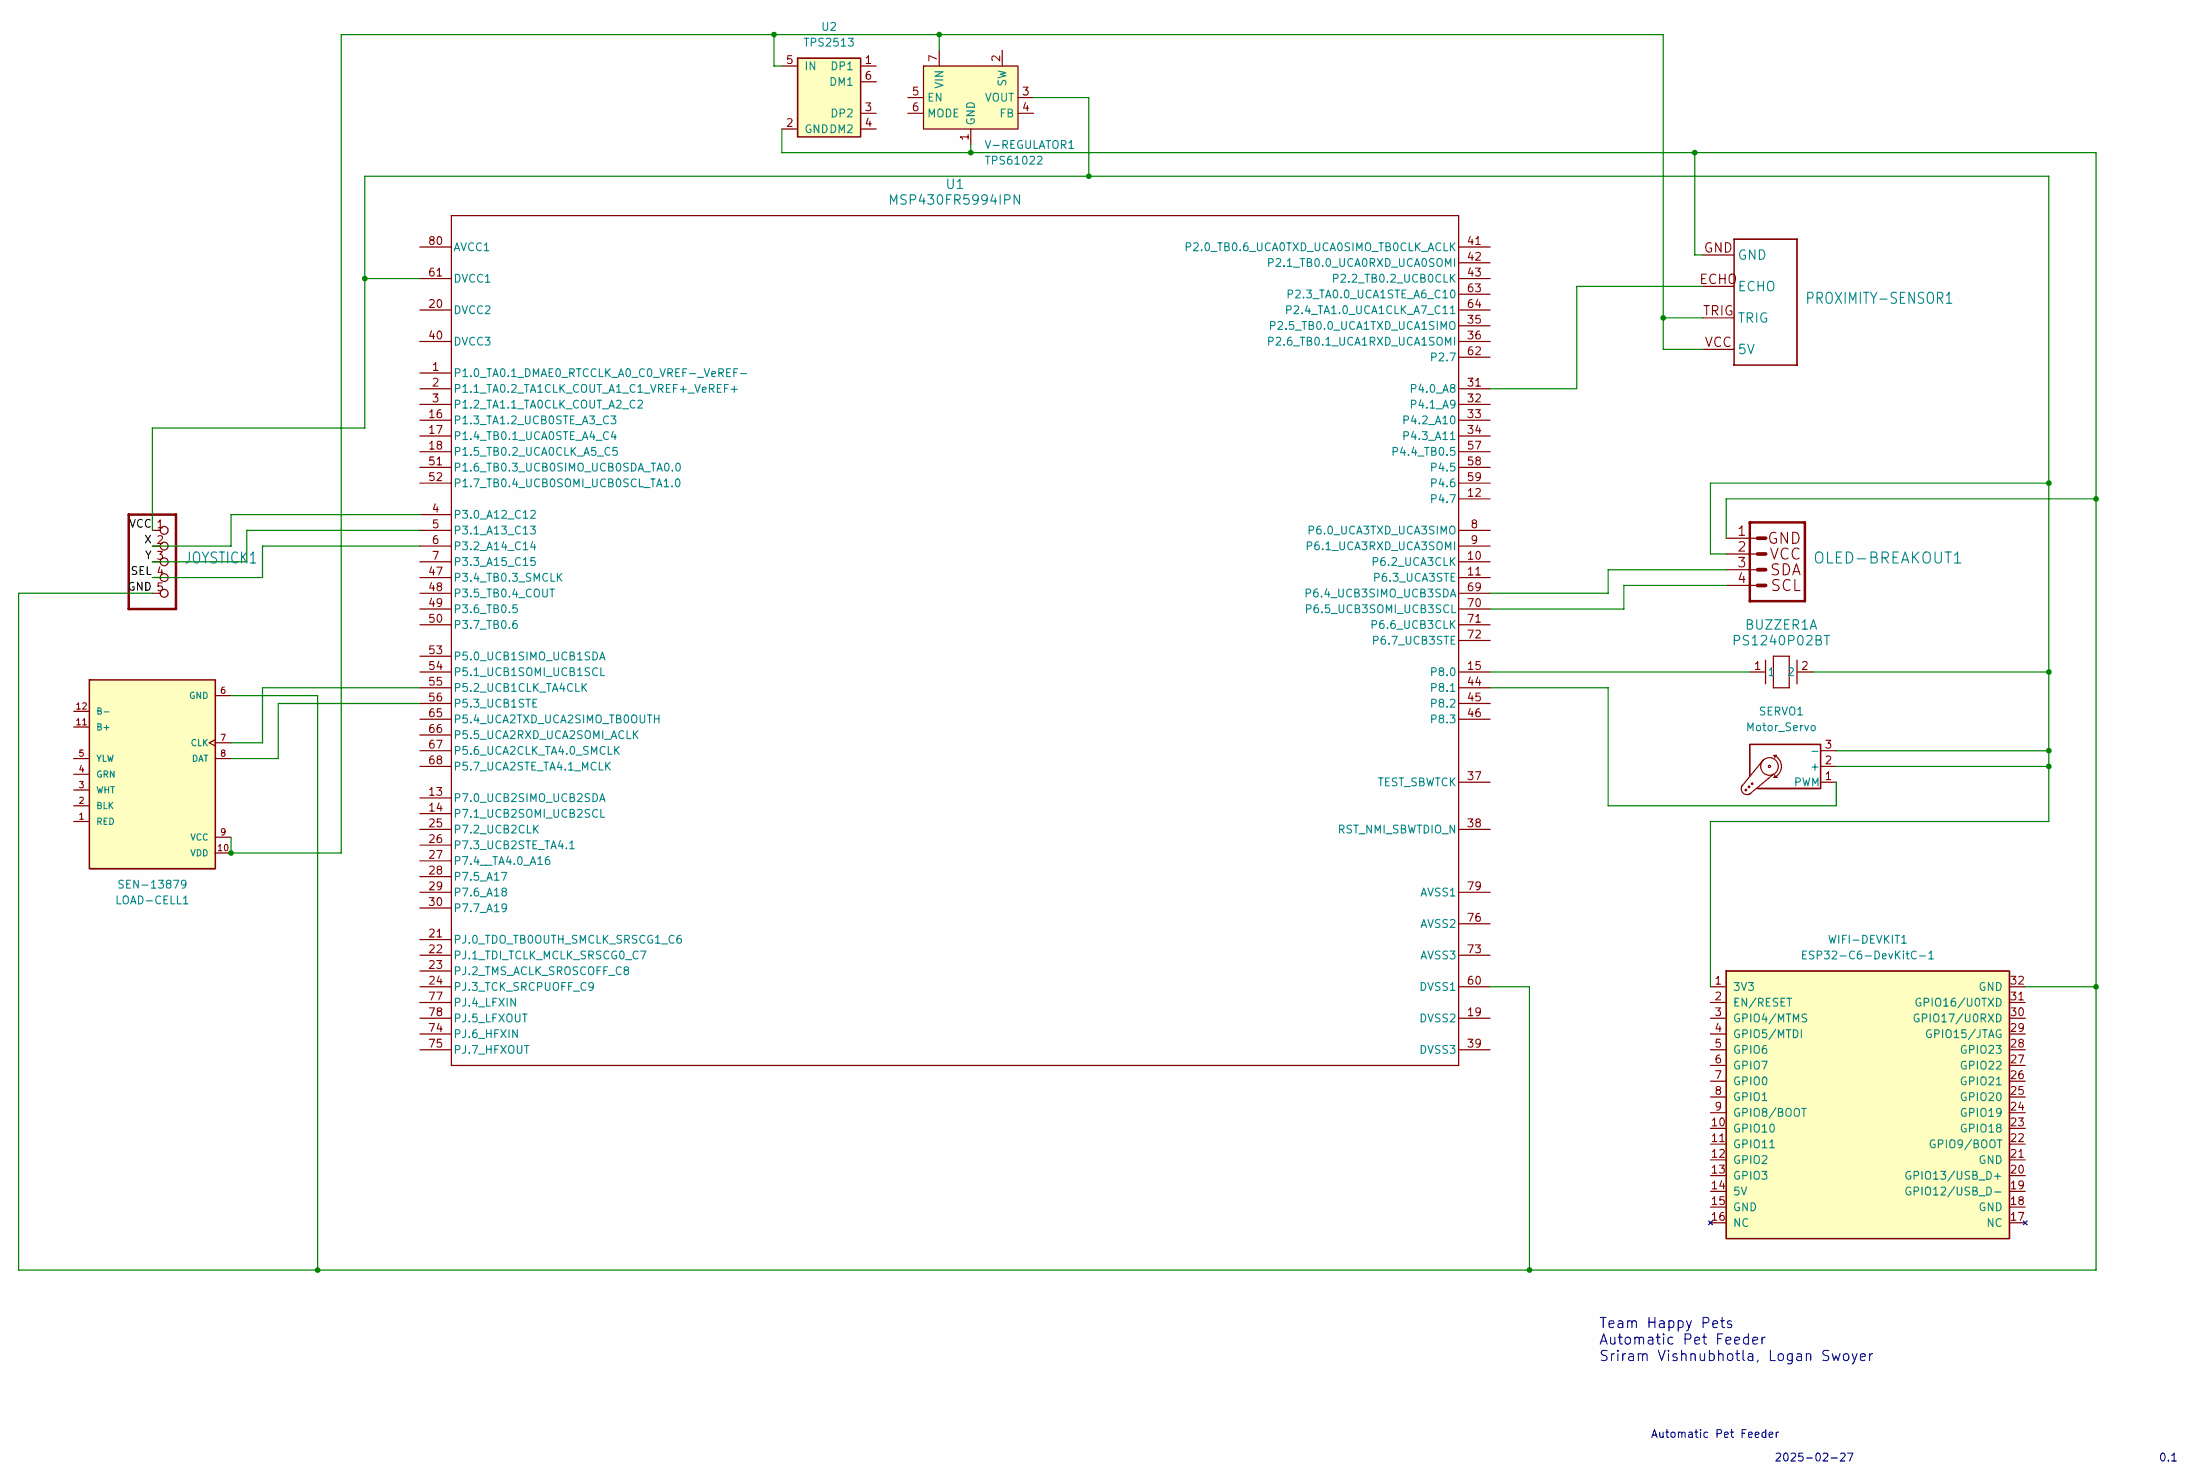
[picture p21: schematic Automatic Pet Feeder.kicad_sch]

Parts:
BUZZER1: PS1240P02BT; XTAL_PS1240P02BT_TDK
JOYSTICK1: 1X05
LOAD-CELL1: SEN-13879; SPARKFUN_SEN-13879
OLED-BREAKOUT1: SPARKX_1X04_NO_SILK
PROXIMITY-SENSOR1: HC-SR04_FOOTPRINT
SERVO1: Motor_Servo; Vybronics_VZ30C1T8219732L
U1: MSP430FR5994IPN; PN0080A_N
U2: TPS2513; SOT-23-6
V-REGULATOR1: TPS61022; Texas_RWU0007A_VQFN-7_2x2mm_P0.5mm
WIFI-DEVKIT1: ESP32-C6-DevKitC-1

Connections:
GND: JOYSTICK1.5, LOAD-CELL1.6 (GND), OLED-BREAKOUT1.1 (GND), PROXIMITY-SENSOR1.GND, U1.60 (DVSS1), U2.2 (GND), V-REGULATOR1.1 (GND), WIFI-DEVKIT1.32 (GND)
unnamed: BUZZER1.1, U1.15 (P8.0)
unnamed: LOAD-CELL1.7 (CLK), U1.55 (P5.2_UCB1CLK_TA4CLK)
unnamed: LOAD-CELL1.8 (DAT), U1.56 (P5.3_UCB1STE)
unnamed: LOAD-CELL1.9 (VCC), LOAD-CELL1.10 (VDD), PROXIMITY-SENSOR1.TRIG, PROXIMITY-SENSOR1.VCC (5V), U2.5 (IN), V-REGULATOR1.7 (VIN)
unnamed: OLED-BREAKOUT1.3 (SDA), U1.69 (P6.4_UCB3SIMO_UCB3SDA)
unnamed: OLED-BREAKOUT1.4 (SCL), U1.70 (P6.5_UCB3SOMI_UCB3SCL)
unnamed: PROXIMITY-SENSOR1.ECHO, U1.31 (P4.0_A8)
unnamed: SERVO1.1 (PWM), U1.44 (P8.1)
SEL: JOYSTICK1.4, U1.6 (P3.2_A14_C14)
VCC: BUZZER1.2, JOYSTICK1.1, OLED-BREAKOUT1.2 (VCC), SERVO1.2 (+), SERVO1.3 (-), U1.61 (DVCC1), V-REGULATOR1.3 (VOUT), WIFI-DEVKIT1.1 (3V3)
X: JOYSTICK1.2, U1.4 (P3.0_A12_C12)
Y: JOYSTICK1.3, U1.5 (P3.1_A13_C13)

Notes on the sheet:
Team Happy Pets Automatic Pet Feeder Sriram Vishnubhotla, Logan Swoyer
0.1
2025-02-27
Automatic Pet Feeder
