openbraces/CPSC-6820/Deliverable #3/Parts/Joystick (512)/Joystick-512.kicad_sch

## KiCad design Deliverable #3/Parts/Joystick (512)/Joystick-512.kicad_sch (2025-02-27)


Parts:
JP1: PINHD-1X5; 1X05
U1: JOYSTICKPTH; JOYSTICK

Connections:
unnamed: JP1.1, U1.B2A (SEL-), U1.H3 (H-), U1.V3 (V-)
unnamed: JP1.2, U1.B1A (SEL+)
unnamed: JP1.3, U1.H2 (H)
unnamed: JP1.4, U1.V2 (V)
unnamed: JP1.5, U1.H1 (H+), U1.V1 (V+)
