openbraces/CPSC-6820/(commit log)

2025-02-18 Added parts
    [joystick.kicad_pcb, joystick.kicad_sch]
2025-02-20 added brd and schematic file
    [Board.brd, schematic.sch]
2025-02-20 Adjusted confusing file names, added EAGLE-compatible libs
    [SEN-13879.step]
2025-02-20 added servo to schematic
    [schematic.sch]
2025-02-20 Added missing EAGLE files, renamed files
    [Automatic Pet Feeder.brd, Automatic Pet Feeder.sch, Joystick-512.kicad_pcb, Joystick-512.kicad_sch]
2025-02-20 Reworked schematic
    [Adafruit WINC1500 Breakout.brd, Adafruit WINC1500 Breakout.sch, Automatic Pet Feeder.sch, Joystick-512.kicad_pcb, Joystick-512.kicad_sch, Qwiic_OLED_1.3in.brd, Qwiic_OLED_1.3in.sch, SEN-13879.step]
2025-02-27 Implement board
    [Adafruit WINC1500 Breakout.brd, Adafruit WINC1500 Breakout.sch, Automatic Pet Feeder.brd, Automatic Pet Feeder.kicad_pcb, Automatic Pet Feeder.kicad_sch, Automatic_Pet_Feeder_1.kicad_sch, Automatic_Pet_Feeder_2.kicad_sch, Automatic_Pet_Feeder_3.kicad_sch]
2025-02-27 Added testing plan, tidied up deliverable #4 files
    [Adafruit WINC1500 Breakout.brd, Adafruit WINC1500 Breakout.sch, Automatic Pet Feeder.kicad_pcb, Automatic Pet Feeder.kicad_sch, Joystick-512.brd, Joystick-512.sch, Qwiic_OLED_1.3in.brd, Qwiic_OLED_1.3in.kicad_sch]
2025-03-13 Added PawPlans files, reworked board and schematic
    [Adafruit WINC1500 Breakout.brd, Adafruit WINC1500 Breakout.sch, Joystick-512.brd, Joystick-512.sch, PawPlans.kicad_pcb, PawPlans.kicad_sch, Qwiic_OLED_1.3in.brd, Qwiic_OLED_1.3in.kicad_sch]
2025-03-14 Completely revamped the schematic and PCB, cleaned up project files
    [Adafruit WINC1500 Breakout.brd, Adafruit WINC1500 Breakout.sch, Joystick-512.brd, Joystick-512.sch, PawPlans.kicad_pcb, PawPlans.kicad_sch, Qwiic_OLED_1.3in.brd, Qwiic_OLED_1.3in.kicad_sch]
2025-03-14 Added board title and credits to silkscreen
    [PawPlans.kicad_pcb]
2025-03-14 Removed MSP430 footprints
2025-03-14 Adjusted the board, switched TDK piezo buzzer for a Murata
    [PawPlans-B_Cu.gbr, PawPlans-B_Mask.gbr, PawPlans-B_Paste.gbr, PawPlans-B_Silkscreen.gbr, PawPlans-Edge_Cuts.gbr, PawPlans-F_Cu.gbr, PawPlans-F_Mask.gbr, PawPlans-F_Paste.gbr]
2025-03-23 Reworked hardware (centered around M5Stack's DinMeter, ESP32), adjusted board and schematic
    [PawPlans-B_Adhesive.gbr, PawPlans-B_Courtyard.gbr, PawPlans-B_Cu.gbr, PawPlans-B_Fab.gbr, PawPlans-B_Mask.gbr, PawPlans-B_Silkscreen.gbr, PawPlans-Edge_Cuts.gbr, PawPlans-F_Adhesive.gbr]
2025-03-23 Changed platform to ESP32-S3
2025-03-23 Adjusted dir structure
    [PawPlans-B_Adhesive.gbr, PawPlans-B_Courtyard.gbr, PawPlans-B_Cu.gbr, PawPlans-B_Fab.gbr, PawPlans-B_Mask.gbr, PawPlans-B_Paste.gbr, PawPlans-B_Silkscreen.gbr, PawPlans-Edge_Cuts.gbr]
2025-03-24 Added select switch statement for root
2025-03-25 Split source files, glued logic together
2025-04-15 added stl file
    [petfeeder2.stl]
2025-04-25 Deliverable #6a
    [PawPlans-B_Adhesive.gbr, PawPlans-B_Courtyard.gbr, PawPlans-B_Cu.gbr, PawPlans-B_Fab.gbr, PawPlans-B_Mask.gbr, PawPlans-B_Paste.gbr, PawPlans-B_Silkscreen.gbr, PawPlans-Edge_Cuts.gbr]
2025-04-25 Switched to using ESP-IDF, implemented core logic
